c3d2/PentaFnord/Mega8_Pinout.ods

Sheet: pinout
 | Atmega88 TQFP32 Pin Usage |  | Port | Special | I2C | UART | Debugwire (JTAG) | SPI | iSP
 | PIN
ledr | 1 | (PCINT19/OC2B/INT1) PD3 | PD3
ledg | 2 | (PCINT20/XCK/T0) PD4 | PD4
 | 3 | GND
 | 4 | VCC
 | 5 | GND
 | 6 | VCC
 | 7 | (PCINT6/XTAL1/TOSC1) PB6 | PB6 | Quarz
 | 8 | (PCINT7/XTAL2/TOSC2) PB7 | PB7 | Quarz
ledb | 9 | (PCINT21/OC0B/T1) PD5 | PD5
ledw | 10 | (PCINT22/OC0A/AIN0) PD6 | PD6
ledu | 11 | (PCINT23/AIN1) PD7 | PD7
Decode ADD | 12 | (PCINT0/CLKO/ICP1) PB0 | PB0
Decode Button 1 | 13 | PB1 (OC1A/PCINT1) | PB1
 | 14 | PB2 (SS/OC1B/PCINT2) | PB2 |  |  |  |  | SS
 | 15 | PB3 (MOSI/OC2A/PCINT3) | PB3 |  |  |  |  | MOSI | MOSI
 | 16 | PB4 (MISO/PCINT4) | PB4 |  |  |  |  | MISO | MISO
 | 17 | PB5 (SCK/PCINT5) | PB5 |  |  |  |  | SCK | SCK
 | 18 | AVCC
 | 19 | ADC6
 | 20 | AREF
 | 21 | GND
 | 22 | ADC7
Decode Btton2 | 23 | PC0 (ADC0/PCINT8) | PC0
Decode Button3 | 24 | PC1 (ADC1/PCINT9) | PC1
Spare ADC2 | 25 | PC2 (ADC2/PCINT10) | PC2
Spare ADC3 | 26 | PC3 (ADC3/PCINT11) | PC3
spi | 27 | PC4 (ADC4/SDA/PCINT12) | PC4 |  | SDA
spi | 28 | PC5 (ADC5/SCL/PCINT13) | PC5 |  | SCL
rst | 29 | (PCINT14/RESET) PC6 | PC6 |  |  |  | RST |  | RESET
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
