c3d2/PentaFnord/hardware/PentaFnord_LedBoard_0_91.brd

## EAGLE design hardware/PentaFnord_LedBoard_0_91.brd (2012-10-28)

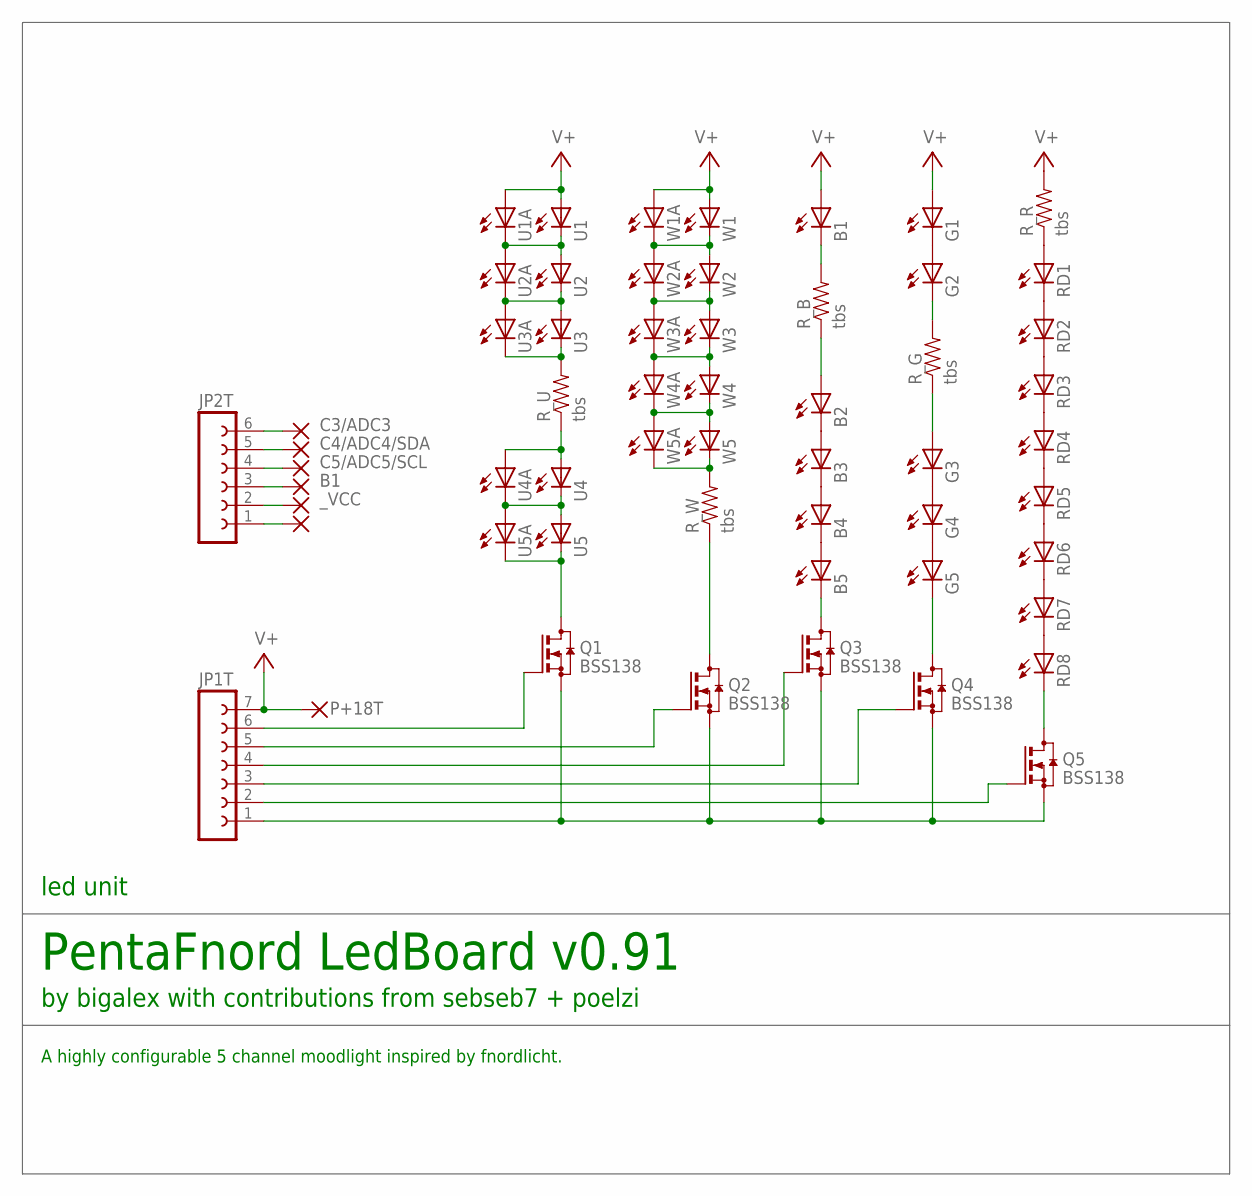
[picture p2: schematic PentaFnord_LedBoard_0_91.sch]

Parts:
B1, B2, B3, B4, B5: LED5MM
G1, G2, G3, G4, G5: LED5MM
JP1T: FE07-1; FE07
JP2T: FE06-1; FE06
P+5T, P+18T: WIREPAD2,54/0,8; 2,54/0,8
PB1T: WIREPAD2,54/0,8; 2,54/0,8
PC3T, PC4T, PC5T: WIREPAD2,54/0,8; 2,54/0,8
PGNDT1: WIREPAD2,54/0,8; 2,54/0,8
Q1, Q2, Q3, Q4, Q5: BSS138; SOT23
RD1, RD2, RD3, RD4, RD5, RD6, RD7, RD8: LED5MM
R_B: tbs; 1206
R_G: tbs; 1206
R_R: tbs; 1206
R_U: tbs; 1206
R_W: tbs; 1206
U1, U2, U3, U4, U5: NICHIA_NSSL157T-H3; PLCC2
U1A, U2A, U3A, U4A, U5A: LED5MM
W1, W2, W3, W4, W5: NICHIA_NSSL157T-H3
W1A, W2A, W3A, W4A, W5A: LED5MM

Connections:
B1: JP2T.3, PB1T.1
C3/ADC3: JP2T.6, PC3T.1
C4/ADC4/SDA: JP2T.5, PC4T.1
C5/ADC5/SCL: JP2T.4, PC5T.1
GND_T: JP1T.1, JP2T.1, PGNDT1.1, Q1.2 (S), Q2.2 (S), Q3.2 (S), Q4.2 (S), Q5.2 (S)
unnamed: B5.K (C), Q3.3 (D)
unnamed: W4.K@1 (C), W4A.K (C), W5.A@2 (A), W5A.A
unnamed: U1.P$1 (C), U1A.K (C), U2.P$2 (A), U2A.A
unnamed: G5.K (C), Q4.3 (D)
unnamed: R_U.2, U3.P$1 (C), U3A.K (C)
unnamed: Q1.3 (D), U5.P$1 (C), U5A.K (C)
unnamed: Q2.3 (D), R_W.1
unnamed: W3.K@1 (C), W3A.K (C), W4.A@2 (A), W4A.A
unnamed: B1.K (C), R_B.2
unnamed: U2.P$1 (C), U2A.K (C), U3.P$2 (A), U3A.A
unnamed: B2.A, R_B.1
unnamed: U4.P$1 (C), U4A.K (C), U5.P$2 (A), U5A.A
unnamed: G1.K (C), G2.A
unnamed: G2.K (C), R_G.2
unnamed: G3.K (C), G4.A
unnamed: G4.K (C), G5.A
unnamed: B2.K (C), B3.A
unnamed: B3.K (C), B4.A
unnamed: B4.K (C), B5.A
unnamed: G3.A, R_G.1
unnamed: RD1.K (C), RD2.A
unnamed: RD2.K (C), RD3.A
unnamed: RD3.K (C), RD4.A
unnamed: RD4.K (C), RD5.A
unnamed: RD5.K (C), RD6.A
unnamed: RD6.K (C), RD7.A
unnamed: RD1.A, R_R.1
unnamed: RD7.K (C), RD8.A
unnamed: R_U.1, U4.P$2 (A), U4A.A
unnamed: Q5.3 (D), RD8.K (C)
unnamed: R_W.2, W5.K@1 (C), W5A.K (C)
unnamed: W2.K@1 (C), W2A.K (C), W3.A@2 (A), W3A.A
unnamed: JP1T.6, Q1.1 (G)
unnamed: JP1T.5, Q2.1 (G)
unnamed: JP1T.3, Q4.1 (G)
unnamed: JP1T.4, Q3.1 (G)
unnamed: JP1T.2, Q5.1 (G)
unnamed: W1.K@1 (C), W1A.K (C), W2.A@2 (A), W2A.A
V+: B1.A, G1.A, JP1T.7, P+18T.1, R_R.2, U1.P$2 (A), U1A.A, W1.A@2 (A), W1A.A
_VCC: JP2T.2, P+5T.1

Notes on the sheet:
led unit
PentaFnord LedBoard v0.91
by bigalex with contributions from sebseb7 + poelzi
A highly configurable 5 channel moodlight inspired by fnordlicht.

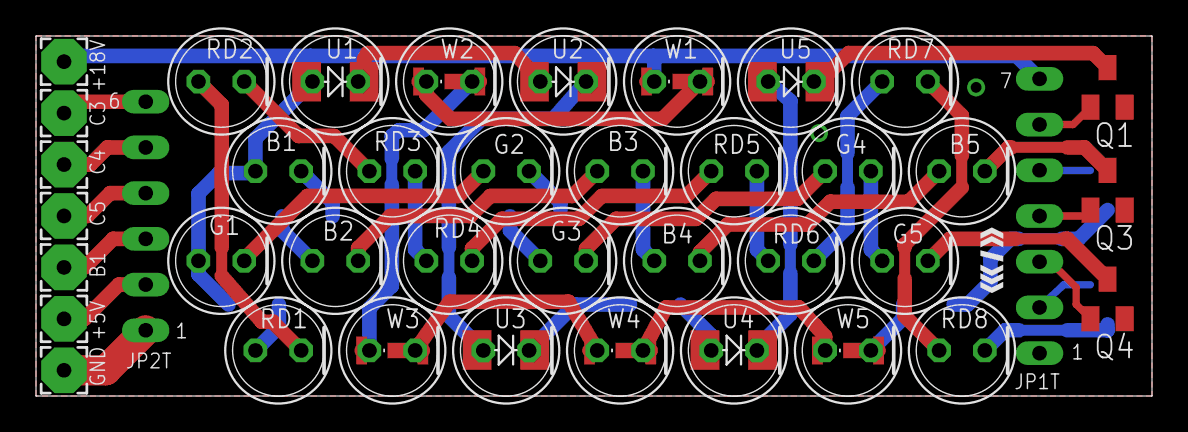
[picture p3: board PentaFnord_LedBoard_0_91.brd from above]

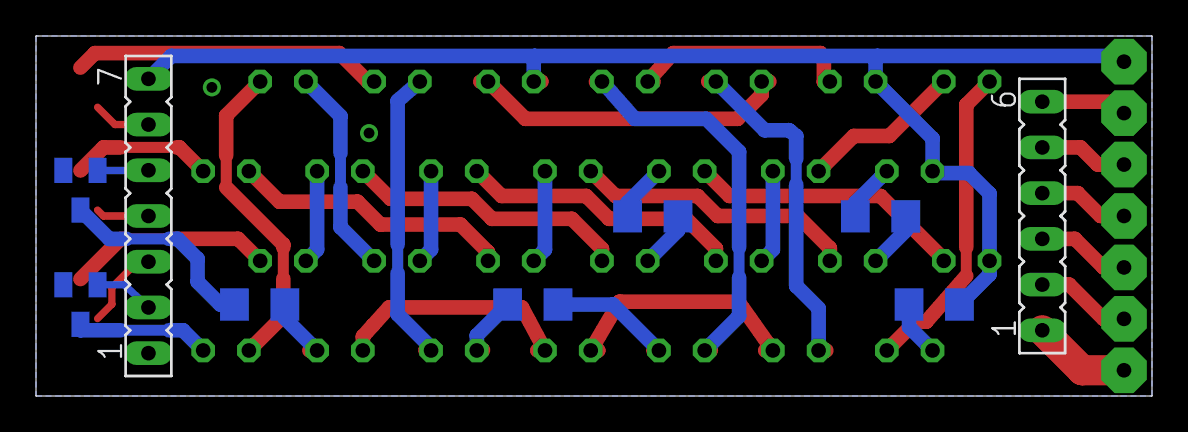
[picture p4: board PentaFnord_LedBoard_0_91.brd from below]

Board: 2 copper layers, 62.0 x 20.0 mm, 57 parts (9 on the bottom side), 45 nets.
