c3d2/PentaFnord/hardware/PentaFnord_CtrlBoard_0_91.brd

## EAGLE design hardware/PentaFnord_CtrlBoard_0_91.brd (2012-10-28)

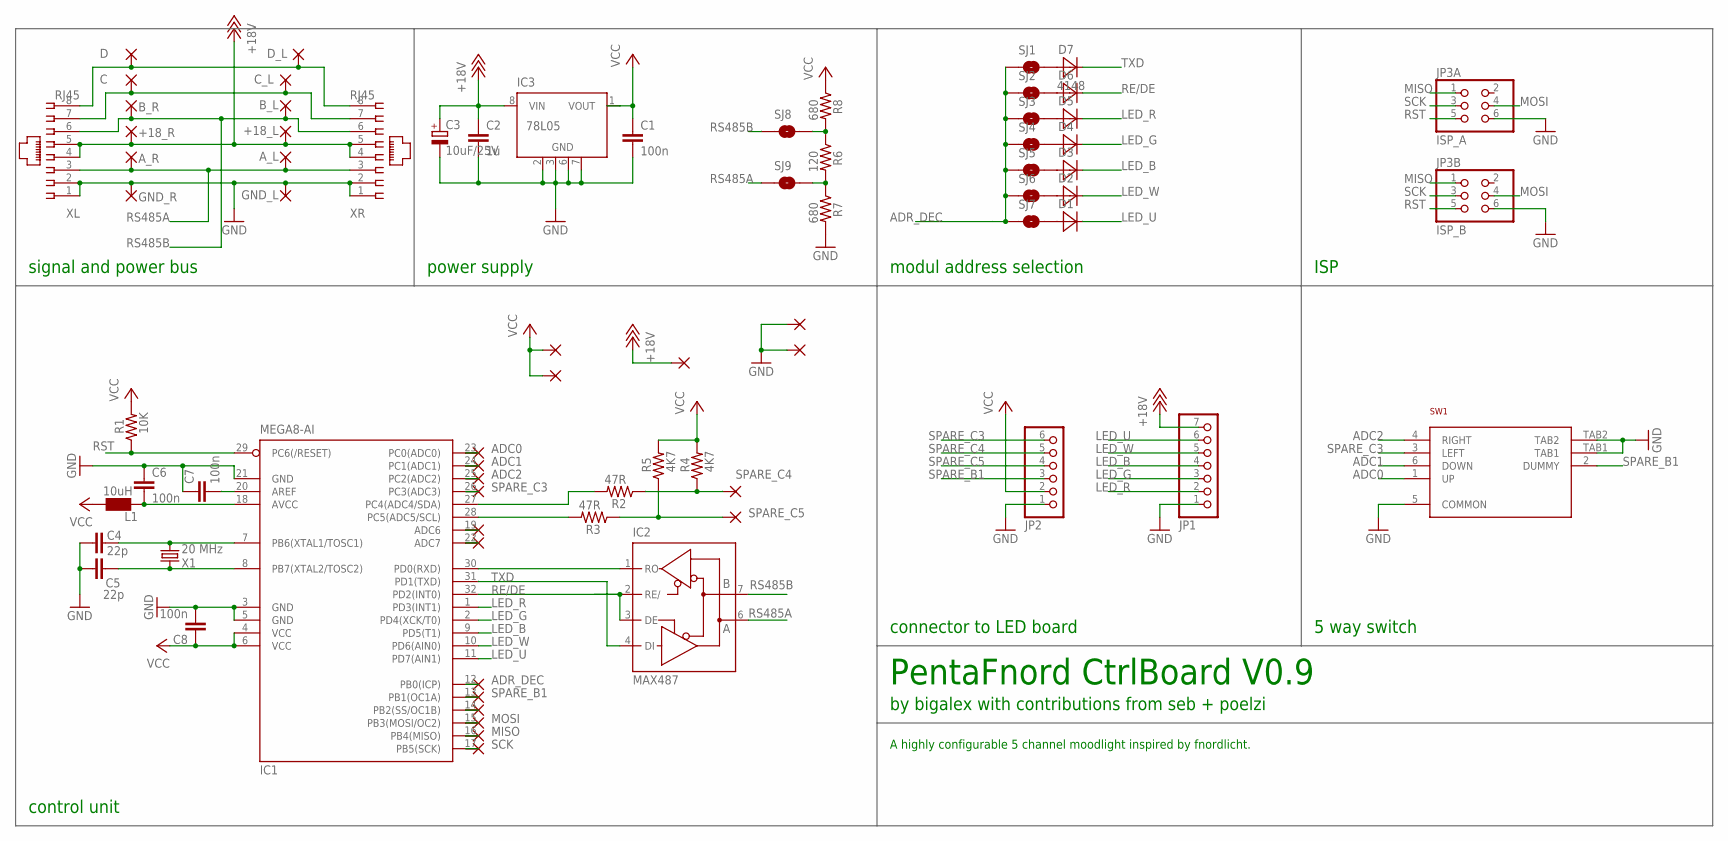
[picture p5: schematic PentaFnord_CtrlBoard_0_91.sch]

Parts:
+18_L, +18_R: WIREPADSMD2,54-5,08; SMD2,54-5,08
ADC6, ADC7: WIREPADSMD1,27-254; SMD1,27-2,54
A_L: WIREPADSMD1,27-254; SMD1,27-2,54
A_R: WIREPADSMD1,27-254; SMD1,27-2,54
B_L: WIREPADSMD1,27-254; SMD1,27-2,54
B_R: WIREPADSMD1,27-254; SMD1,27-2,54
C: WIREPADSMD1,27-254; SMD1,27-2,54
C1, C6, C7, C8: 100n; 0805
C2: 1u; 0805
C3: 10uF/25V; SMC_D
C4, C5: 22p; 0805
C_L: WIREPADSMD1,27-254; SMD1,27-2,54
D: WIREPADSMD1,27-254; SMD1,27-2,54
D1, D2, D3, D4, D5, D6: DIODE_0805
D7: 4148; DIODE_0805
D_L: WIREPADSMD1,27-254; SMD1,27-2,54
GND_L: WIREPADSMD2,54-5,08; SMD2,54-5,08
GND_R: WIREPADSMD2,54-5,08; SMD2,54-5,08
IC1: MEGA8-AI; TQFP32-08
IC2: MAX487; SO08
IC3: 78L05; SO08
JP1: PINHD-1X07_2.54-SMD-REVERSE; 1X07SMD-REVERSE
JP2: PINHD-1X06_2.54-SMD; 1X06SMD
JP3A: ISP_A; 2X03SMD
JP3B: ISP_B; 2X03SMD
L1: 10uH; 0805
PAD1, PAD2, PAD3, PAD4, PAD5: WIREPADSMD1,27-254; SMD1,27-2,54
PB0, PB1, PB2, PB3, PB4, PB5: WIREPADSMD1,27-254; SMD1,27-2,54
PC0, PC1, PC2, PC3, PC4, PC5: WIREPADSMD1,27-254; SMD1,27-2,54
R1: 10K; 0805
R2, R3: 47R; 0805
R4, R5: 4K7; 0805
R6: 120; 0805
R7, R8: 680; 0805
SJ1, SJ2, SJ3, SJ4, SJ5, SJ6, SJ7, SJ8, SJ9: SOLDERJUMPERNO; SJ_2S-NO
SW1: MCMT5-F-VADAPTED_FOOTPRINT; MCMT5-F-V_ADAPTED
X1: 20 MHz; HC49UP-SMALL
XL: RJ45; 85502-5008-SMALL
XR: RJ45; 85502-5008-SMALL

Connections:
+18V: +18_L.1, +18_R.1, C2.1, C3.+, IC3.8 (VIN), JP1.7, PAD2.1, XL.4, XL.5, XR.4, XR.5
ADC0: IC1.23 (PC0(ADC0)), PC0.1, SW1.1 (UP)
ADC1: IC1.24 (PC1(ADC1)), PC1.1, SW1.6 (DOWN)
ADC2: IC1.25 (PC2(ADC2)), PC2.1, SW1.4 (RIGHT)
ADR_DEC: IC1.12 (PB0(ICP)), PB0.1, SJ1.1, SJ2.1, SJ3.1, SJ4.1, SJ5.1, SJ6.1, SJ7.1
GND: C1.2, C2.2, C3.-, C4.1, C5.1, C6.1, C7.1, C8.2, GND_L.1, GND_R.1, IC1.3 (GND), IC1.5 (GND), IC1.21 (GND), IC2.5 (GND), IC3.2 (GND), IC3.3 (GND), IC3.6 (GND), IC3.7 (GND), JP1.1, JP2.1, JP3A.6, JP3B.6, PAD1.1, PAD5.1, R7.2, SW1.5 (COMMON), SW1.TAB1, SW1.TAB2, XL.1, XL.2, XR.1, XR.2
LED_B: D3.1 (C), IC1.9 (PD5(T1)), JP1.4
LED_G: D4.1 (C), IC1.2 (PD4(XCK/T0)), JP1.3
LED_R: D5.1 (C), IC1.1 (PD3(INT1)), JP1.2
LED_U: D1.1 (C), IC1.11 (PD7(AIN1)), JP1.6
LED_W: D2.1 (C), IC1.10 (PD6(AIN0)), JP1.5
MISO: IC1.16 (PB4(MISO)), JP3A.1, JP3B.1, PB4.1
MOSI: IC1.15 (PB3(MOSI/OC2)), JP3A.4, JP3B.4, PB3.1
unnamed: C.1, C_L.1, XL.7, XR.7
unnamed: D.1, D_L.1, XL.8, XR.8
unnamed: ADC6.1, IC1.19 (ADC6)
unnamed: ADC7.1, IC1.22 (ADC7)
unnamed: C6.2, IC1.18 (AVCC), L1.2
unnamed: R6.1, R8.2, SJ8.2
unnamed: IC1.30 (PD0(RXD)), IC2.1 (RO)
unnamed: C5.2, IC1.8 (PB7(XTAL2/TOSC2)), X1.2
unnamed: C4.2, IC1.7 (PB6(XTAL1/TOSC1)), X1.1
unnamed: R6.2, R7.1, SJ9.2
unnamed: C7.2, IC1.20 (AREF)
unnamed: D7.2 (A), SJ1.2
unnamed: D6.2 (A), SJ2.2
unnamed: D5.2 (A), SJ3.2
unnamed: D4.2 (A), SJ4.2
unnamed: D3.2 (A), SJ5.2
unnamed: D2.2 (A), SJ6.2
unnamed: D1.2 (A), SJ7.2
unnamed: IC1.28 (PC5(ADC5/SCL)), R3.2
unnamed: IC1.14 (PB2(SS/OC1B)), PB2.1
unnamed: IC1.27 (PC4(ADC4/SDA)), R2.2
RE/DE: D6.1 (C), IC1.32 (PD2(INT0)), IC2.2 (RE/), IC2.3 (DE)
RS485A: A_L.1, A_R.1, IC2.6 (A), SJ9.1, XL.3, XR.3
RS485B: B_L.1, B_R.1, IC2.7 (B), SJ8.1, XL.6, XR.6
RST: IC1.29 (PC6(/RESET)), JP3A.5, JP3B.5, R1.1
SCK: IC1.17 (PB5(SCK)), JP3A.3, JP3B.3, PB5.1
SPARE_B1: IC1.13 (PB1(OC1A)), JP2.3, PB1.1, SW1.2 (DUMMY)
SPARE_C3: IC1.26 (PC3(ADC3)), JP2.6, PC3.1, SW1.3 (LEFT)
SPARE_C4: JP2.5, PC4.1, R2.1, R4.1
SPARE_C5: JP2.4, PC5.1, R3.1, R5.1
TXD: D7.1 (C), IC1.31 (PD1(TXD)), IC2.4 (DI)
VCC: C1.1, C8.1, IC1.4 (VCC), IC1.6 (VCC), IC2.8 (VCC), IC3.1 (VOUT), JP2.2, L1.1, PAD3.1, PAD4.1, R1.2, R4.2, R5.2, R8.1

Notes on the sheet:
signal and power bus
power supply
control unit
PentaFnord CtrlBoard V0.9
by bigalex with contributions from seb + poelzi
A highly configurable 5 channel moodlight inspired by fnordlicht.
modul address selection
ISP
connector to LED board
5 way switch

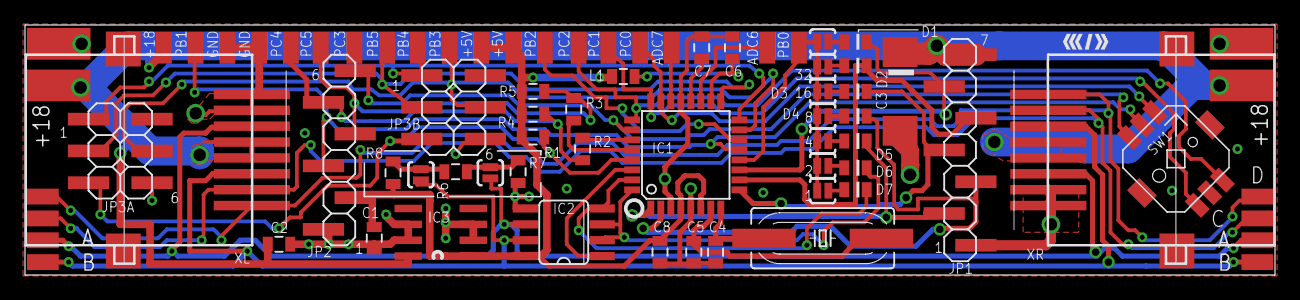
[picture p6: board PentaFnord_CtrlBoard_0_91.brd from above]

Board: 2 copper layers, 100.0 x 20.0 mm, 75 parts (0 on the bottom side), 45 nets.
