c3d2/PentaFnord/(commit log)

2011-09-25 Initial Version of schematics and board layout
    [PentaFnord.brd, PentaFnord.sch]
2011-10-03 Not entirely incomplete version of schematics. LED placement on PCB allowing for 25mm x 25 mm profile (assembled PCB width < 21 mm)
    [PentaFnord.brd, PentaFnord.sch]
2011-10-04 Routed I2C to upper board. Pullup resistors for I2C added.
    [PentaFnord.brd, PentaFnord.sch]
2011-10-05 Board interconector placement, RJ45 SMD footprint added, modul address decoding added, lots of other improvements
    [PentaFnord.brd, PentaFnord.sch]
2011-10-06 Upper board routed
    [PentaFnord.brd, PentaFnord.sch]
2011-10-07 Started Layout of bottom PCB
    [PentaFnord.brd, PentaFnord.sch]
2011-10-07 some routing done, but more left
    [PentaFnord.brd]
2011-10-08 Some routing improvements, replaced 1805 by smaller 78L05
    [PentaFnord.brd, PentaFnord.sch]
2011-10-09 Some more routing done
    [PentaFnord.brd, PentaFnord.sch]
2011-10-10 Even much more routing done
    [PentaFnord.brd, PentaFnord.sch]
2011-10-11 some ripup due to insufficient groundpath in groundplane
    [PentaFnord.brd, PentaFnord.sch]
2011-10-12 some routing
    [PentaFnord.brd]
2011-10-19 routing, placement print, bigger blocking Cs, value for basis resistor adapted
    [PentaFnord.brd, PentaFnord.sch]
2011-10-20 groundplanes, placement print placing, some renaming of components
    [PentaFnord.brd, PentaFnord.sch]
2011-10-21 parts enumeration, placement print
    [PentaFnord.brd, PentaFnord.sch]
2011-10-21 nearing completion. all labels for names and placement ... ummm ... placed
    [PentaFnord.brd, PentaFnord.sch]
2011-10-22 Renaming for save experimenting with 5-way-switch instead of 3 tactile buttons
    [PentaFnord_0_1b.brd, PentaFnord_0_1b.sch]
2011-10-22 Initial checkin. Trying to integrate a 5-way-switch.
    [PentaFnord_0_2b.brd, PentaFnord_0_2b.sch]
2011-10-23 Some schematics beautification. 5 way switch fully integrated
    [PentaFnord_0_2b.brd, PentaFnord_0_2b.sch]
2011-10-23 Replacded 1206 resistors for RGBU-Leds with 805 to avoid keepout problems. Version imprint on boards updated.
    [PentaFnord_0_2b.brd, PentaFnord_0_2b.sch]
2011-10-23 Pinout-Doku added
    [Mega8_Pinout.ods]
2011-10-28 version 3 created for integrating feedback
    [PentaFnord_0_3b.brd, PentaFnord_0_3b.sch]
2011-11-01 Integrating recoomendations and improvements
    [PentaFnord_0_3b.brd, PentaFnord_0_3b.sch]
2011-11-17 Added optional terminator an bias resistors for RS485 (with solder jumpers)
    [PentaFnord_0_3b.brd, PentaFnord_0_3b.sch]
2011-11-21 polishing routing
    [PentaFnord_0_3b.brd]
2011-11-24 moar features, will hack correct pinhead distance for pads (or at least try to)
    [PentaFnord_0_3b.brd, PentaFnord_0_3b.sch, PentaFnord_0_4b.brd, PentaFnord_0_4b.sch]
2011-12-05 realigned solderpads for general signal breakouts to support optional mounting of pinheader
    [PentaFnord_0_4b.brd, PentaFnord_0_4b.sch]
2011-12-11 v0.4 layout, print
    [PentaFnord_0_4b.brd, PentaFnord_0_4b.sch]
2011-12-18 c3d2-logo CI conform
    [PentaFnord_0_4b.brd]
2012-01-01 some things done (hell yeah, i know this is a bit unspecific, but who cares)
    [PentaFnord_0_4b.brd, PentaFnord_0_4b.sch]
2012-01-07 Trying to integrate two more freakin line protection resistors into this overcrowded board
    [PentaFnord_0_4b.sch, PentaFnord_0_9b.brd, PentaFnord_0_9b.sch]
2012-01-09 smaller resistors and solderjumpers, some ripup to make room for lager (and mich, much cheaper) crytstal
    [PentaFnord_0_9b.brd, PentaFnord_0_9b.sch]
2012-01-10 crash recovery
    [PentaFnord_0_9b.brd, PentaFnord_0_9b.sch]
2012-01-10 crash recovered, routing done, placement print donde, lets look forward what we might find to improve
    [PentaFnord_0_9b.brd, PentaFnord_0_9b.sch]
2012-01-10 conflict resolved
    [PentaFnord_0_9b.brd]
2012-01-12 replaced diodes with 0805 type, rank for groundplane fixes unnecessary trestrict
    [PentaFnord_0_9b.brd, PentaFnord_0_9b.sch]
2012-01-19 Added tatnatl SMC-D capacitor but found no place for it yet
    [PentaFnord_0_9b.brd, PentaFnord_0_9b.sch]
2012-01-19 smaller footprint for rj45 connector avoids violation of board boundaries
    [PentaFnord_0_9b.brd, PentaFnord_0_9b.sch]
2012-01-19 electrolytic cap placed after some rearangements, still need to tidy up
    [PentaFnord_0_9b.brd, PentaFnord_0_9b.sch]
2012-01-20 already quite nice, did a bit of tidying up
    [PentaFnord_0_9b.brd]
2012-01-22 last edit (GND via) before splitting up files for Led- and Ctrl-Board
    [PentaFnord_0_9b.brd]
2012-01-22 design files splitted into LedBoard and CtrlBoard, tidied up a bit
    [PentaFnord_0_1b.brd, PentaFnord_0_1b.sch, PentaFnord_0_2b.brd, PentaFnord_0_2b.sch, PentaFnord_0_3b.brd, PentaFnord_0_3b.sch, PentaFnord_0_4b.brd, PentaFnord_0_4b.sch]
2012-01-23 footprint of 5way switch optimized, some distance optimizations for components
    [PentaFnord_CtrlBoard_0_9.brd, PentaFnord_CtrlBoard_0_9.sch]
2012-01-25 Polarity markings for electrolytic c in t_place
    [PentaFnord_CtrlBoard_0_9.brd]
2012-02-05 trying to route additional bus wires fromone end of the board to the other. insane, but will work, not yet done.
    [PentaFnord_CtrlBoard_0_9.brd, PentaFnord_CtrlBoard_0_9.sch]
2012-02-05 alle data bus wires connected troughout the board
    [PentaFnord_CtrlBoard_0_9.brd, PentaFnord_CtrlBoard_0_9.sch]
2012-02-08 genesis constant current led board
    [PentaFnord_CcsBoard_0_1.brd, PentaFnord_CcsBoard_0_1.sch]
2012-02-10 first completetely routed draft of power led board
    [PentaFnord_CcsBoard_0_1.brd, PentaFnord_CcsBoard_0_1.sch]
2012-02-10 renamed power led board
    [PentaFnord_PowerLedBoard_0_1.brd, PentaFnord_PowerLedBoard_0_1.sch]
2012-02-11 started arranging placement print
    [PentaFnord_PowerLedBoard_0_1.brd, PentaFnord_PowerLedBoard_0_1.sch]
2012-02-12 Placement print finished so far
    [PentaFnord_PowerLedBoard_0_1.brd, PentaFnord_PowerLedBoard_0_1.sch]
2012-02-13 proposal for routing under inductivities
    [PentaFnord_PowerLedBoard_0_1.brd]
2012-02-14 replaced smd inductivities with wired components
    [PentaFnord_PowerLedBoard_0_1.brd, PentaFnord_PowerLedBoard_0_1.sch]
2012-02-16 routing for wired inductivities done
    [PentaFnord_PowerLedBoard_0_1.brd, PentaFnord_PowerLedBoard_0_1.sch]
2012-04-25 specified values for C3 and D1
    [PentaFnord_CtrlBoard_0_9.brd, PentaFnord_CtrlBoard_0_9.sch]
2012-04-26 added image of board001
2012-04-29 Documented First Time Operation and (mostly avoidable) bugs encountered when assembling the board and powering it up for the first time
2012-05-01 added meassured values vor the sum of forward voltages in each led strand
2012-05-01 linebreaks in tabe for forward voltages in each led strand
2012-05-01 one more linebreak in table for forward voltages in each led strand
2012-05-02 values for resistors (and measured current) in place added
2012-05-29 alternative exponential pwm table
2012-06-03 removed functions and structures for specifying and converting colors as HSV values to keep code lean and avoid using to much memory for barely used functions
    [main.c]
2012-06-05 now all buttons are read
2012-06-05 fixed bug in fadinng
    [main.c]
2012-06-10 starting rework for LED Board
    [PentaFnord_CtrlBoard_0_9.brd, PentaFnord_CtrlBoard_0_9.sch, PentaFnord_LedBoard_0_9.brd, PentaFnord_LedBoard_0_9.sch, PentaFnord_LedBoard_0_91.brd, PentaFnord_LedBoard_0_91.sch, PentaFnord_PowerLedBoard_0_1.brd, PentaFnord_PowerLedBoard_0_1.sch]
2012-06-10 renaming CtrlBoard for integrating future fixes
    [PentaFnord_CtrlBoard_0_91.brd, PentaFnord_CtrlBoard_0_91.sch]
2012-06-10 PentaFnord_CtrlBoard_0_91.b#1
    corrected wrong numbering of JP2 pins, version ID on bottom went up from 0.9 to 0.91
    [PentaFnord_CtrlBoard_0_91.brd]
2012-06-10 recvery point. starting to integrate rs485 routines
    [PentaFnord_LedBoard_0_91.brd, PentaFnord_LedBoard_0_91.sch]
2012-06-10 uart protocols and first test added
2012-06-17 fusebits im Makefile entsprechend Alex’ Vorgabe
2012-06-17 Fixed state machine, so button states do no longer hang in states that are not asked for (and therefore will not be reset)
2012-06-17 fixed warning implicit function
    [main.c]
2012-06-25 replaced values of R6-R9 with value in use (5K instead of 5.6K)
    [PentaFnord_PowerLedBoard_0_1.brd, PentaFnord_PowerLedBoard_0_1.sch]
2012-06-25 some routing for improved LED Board done
    [PentaFnord_LedBoard_0_91.brd, PentaFnord_LedBoard_0_91.sch]
2012-10-23 values for smd led board
2012-10-28 added manufactured version of 0.91 LED board
    [PentaFnord_LedBoard_0_91.brd, PentaFnord_LedBoard_0_91.sch]
2012-10-28 Numbering of ICs correchted
    [PentaFnord_CtrlBoard_0_91.brd, PentaFnord_CtrlBoard_0_91.sch]
2012-10-28 added placement schematics for PFLB
2012-10-28 added schematics for PFLB
2012-10-28 parts list and pricing for LED board
2012-11-10 LedBar - reduced board.
    [PentaFnord_LedBar_0_91r.brd, PentaFnord_LedBar_0_91r.sch]
2012-11-10 moar routing
    [PentaFnord_LedBar_0_91r.brd]
2012-11-10 routing done
    [PentaFnord_LedBar_0_91r.brd, PentaFnord_LedBar_0_91r.sch]
2013-01-19 file format change to new eagle 6 (xml instead of binary)
    [PentaFnord_LedBoard_0_91.brd, PentaFnord_LedBoard_0_91.sch]
2013-01-20 repo cleanup and sync with working copy
    [pwmtable.ods]
2013-01-20 linked to led bar hack
2013-01-20 beutified button detection
