c3d2/PentaFnord/(notices)

Notices in the files:
firmware/main.c:
under the terms of the GNU General Public License version 3 as published by
the Free Software Foundation.
